idrucheez/Smart-RainGuard-Drying-Rack-System/images/README.md

# Images

Add clear photographs or diagrams using descriptive filenames, for example:

- `complete_prototype.jpg`
- `wiring_overview.jpg`
- `bts7960_connections.jpg`
- `rain_sensor_test.jpg`
- `motor_and_spool.jpg`
- `battery_and_buck_converter.jpg`
- `cover_retracted.jpg`
- `cover_extended.jpg`

Avoid committing images that reveal private information, serial numbers, student IDs, or unsafe exposed battery wiring.
