idrucheez/Smart-RainGuard-Drying-Rack-System/images/6235768536831824173_121.jpg

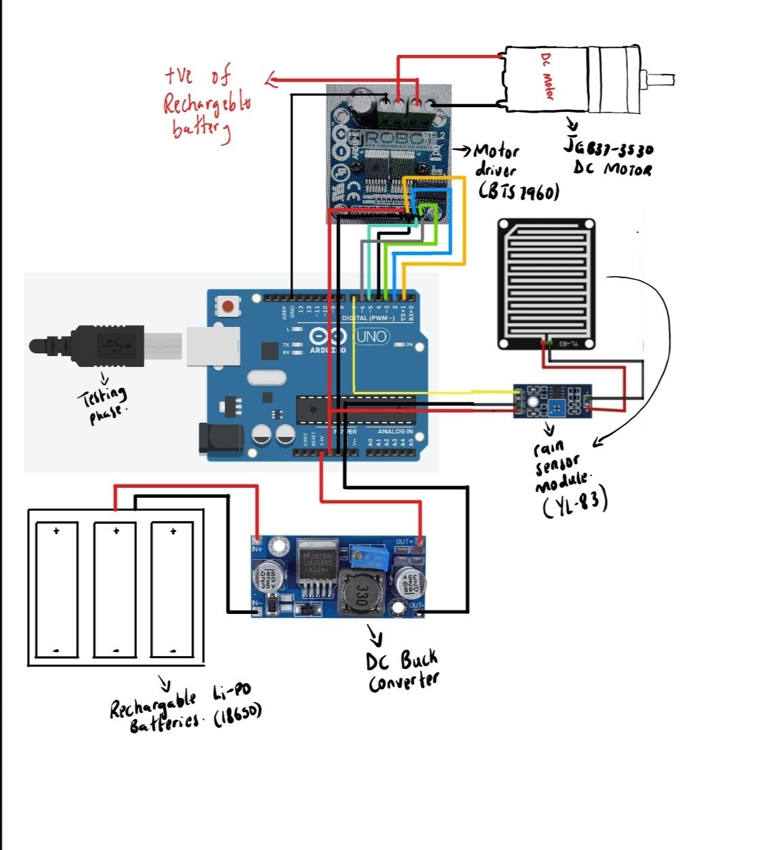
images/6235768536831824173_121.jpg
