idrucheez/Smart-RainGuard-Drying-Rack-System/images/6280450700814782715_121.jpg

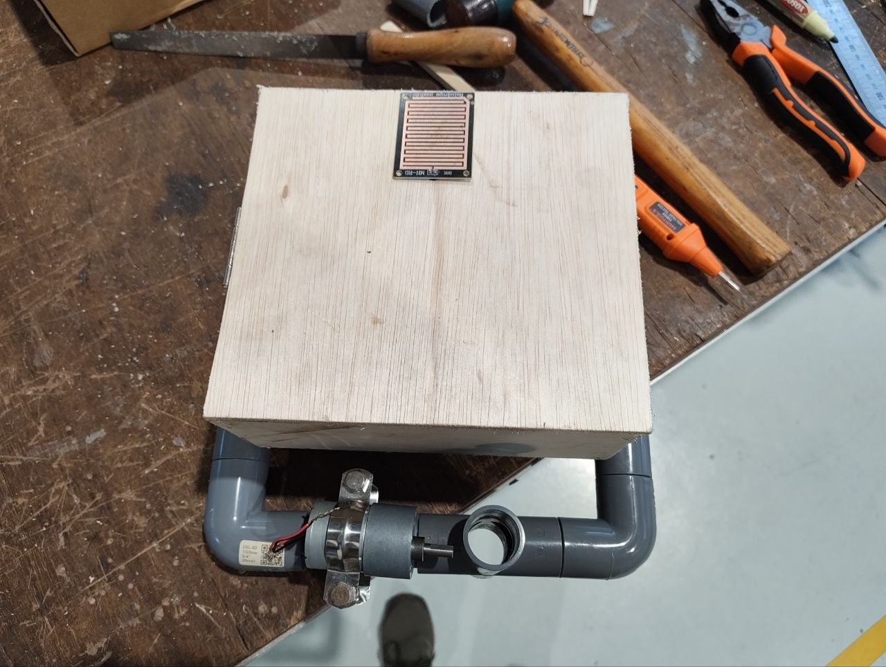
images/6280450700814782715_121.jpg
