idrucheez/Smart-RainGuard-Drying-Rack-System/docs/BILL_OF_MATERIALS.md

# Bill of Materials

| Quantity | Item | Recommended specification |
|---:|---|---|
| 1 | Arduino Uno | 5 V logic |
| 1 | YL-83 rain sensor module | Sensor plate plus LM393 interface board |
| 1 | BTS7960 / IBT-2 driver | High-current H-bridge module |
| 1 | JGB37-3530 DC gear motor | 12 V, 111 RPM |
| 3 | 18650 lithium-ion cells | Matched, genuine, suitable discharge rating |
| 1 | LM2596 buck converter | Adjustable, regulated 5 V logic output |
| 1 | Main power switch | DC rated above expected current |
| 2 | Limit switches | Strongly recommended |
| As required | rain-cover material | Mechanical assembly |
